hyperair/motor-wheel-coupling/(commit log)

2014-08-15 Add initial wheel-coupling.scad
    [wheel-coupling.scad]
2014-08-16 Add flange and top of shaft
    [wheel-coupling.scad]
2014-08-16 Fix the key width -- it's 17mm.
    [wheel-coupling.scad]
2014-08-16 Fix motor shaft depth
    [wheel-coupling.scad]
2014-08-16 Extend motor shaft depth
    [wheel-coupling.scad]
2014-08-16 Add shaft screw settings
    [wheel-coupling.scad]
2014-08-16 Reduce flange diameter
    [wheel-coupling.scad]
2014-08-16 Increase collar thickness
    [wheel-coupling.scad]
2014-08-16 Increase clearance for motor shaft and shaft nut
    [wheel-coupling.scad]
2014-08-16 Fix collar thickness change
    It was collar_wall_thickness, not collar_thickness.
    [wheel-coupling.scad]
2014-08-17 Reduce setscrew clearance
    We seem to be grinding down the walls of the nut trap when removing the
    setscrew.
    [wheel-coupling.scad]
2014-08-17 Use less clearance for motor shaft
    Hopefully reduces the amount of stress on thin plastic
    [wheel-coupling.scad]
2014-08-17 Render a flattened motor shaft instead of cylindrical one
    This takes some of the stress off the joint between the thinner shaft and the
    collar. Also allows us to put the nut nearer to the shaft.
    [wheel-coupling.scad]
2014-08-17 Reduce collar wall thickness
    It doesn't need to be so far out any more.
    [wheel-coupling.scad]
